NOA-ReACT/electricity-sensors/pcb/images/electrode_production_image1.jpg

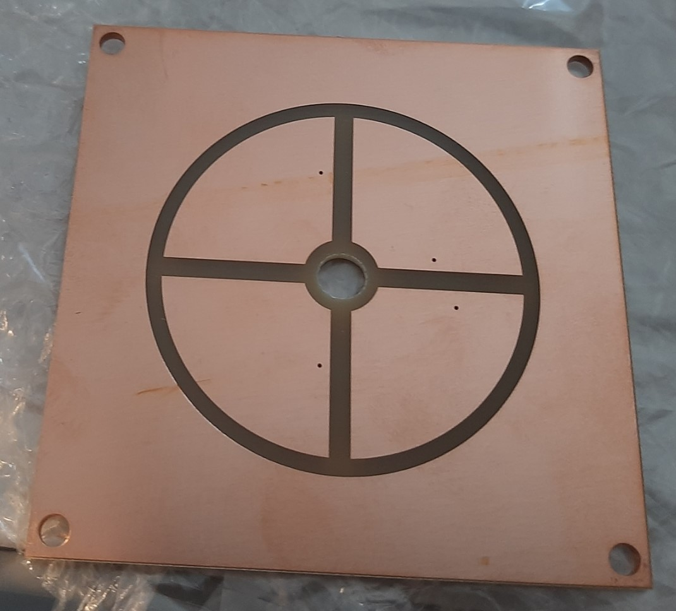
pcb/images/electrode_production_image1.jpg
