NOA-ReACT/electricity-sensors/pcb/images/electrode_production_image2.jpg

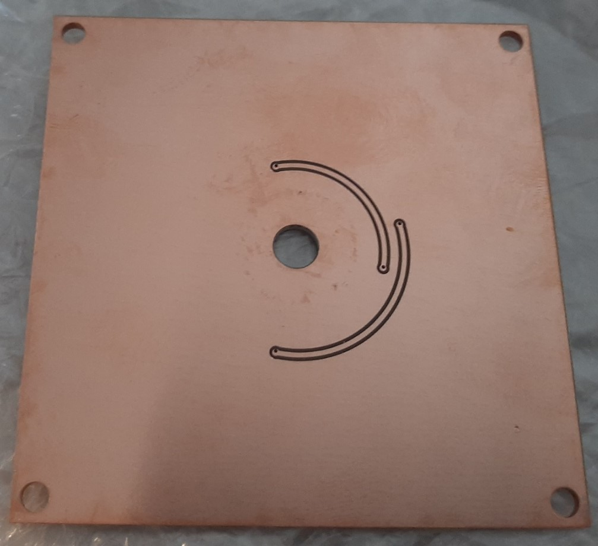
pcb/images/electrode_production_image2.jpg
