NOA-ReACT/electricity-sensors/specs/Charge_sensor_specs.pdf

### NOA - Space Charge Sensor Specs

as in Nicoll & Harrison 2009 , Nicoll 2013

Baud Rate | | Dynamic range
Pre Radiosonde | 115200 | single sensitive channel
On Radiosonde | 9600
| 8 data bits, no parity, one stop bit
| (8N1)
Electrode | | Noise
Brass - spherical | | Zero field error | 1 ADC cnt
Diameter | 15mm | Dark voltage | ~ 4.6mV
Effective Diameter (deff) | 25.4mm
Sampling Rate | | Sensitivity | ± 2.3mV
Pre Radiosonde | 9500 Samples Per Second
On Radiosonde | 1 Sample Per Second | Resolution | ± 2.5V
Modes: | | Accuracy | ~ 10mV
state0 | Regular measurement
state1 | Calibration period 1 | Bandwidth (dB) | through UART
state2 | Calibration period 2 | | Radiosonde defined bandwidth
| | Physical
Spherical Electrode | | Mass | 90 gr (without battery)
Material | Brass | Power | 9V batteries (DC in)
Diameter | 15mm | Consumption | < 100mA
Thickeness | 1.5mm hollow
PCB type: | | Project Box Dimensions:
PCB1 | FR4 1 mm, 35/35μm, double sided
| (PTH), finish: HAL, 34X26mm | Height | 43.8mm
PCB2 | FR4 1 mm, 35/35μm, double sided
| (PTH), finish: HAL, 50X28mm | Length | 101mm
| | Width | 54mm
Microcontroller type
Arduino Nano CH340

Operating environment
Temperature | up to -60o C (with project box)
Altitude | msl to 16km
Humidity | to 100%
