NOA-ReACT/electricity-sensors/pcb/fieldmill_Block_Diagram.jpg

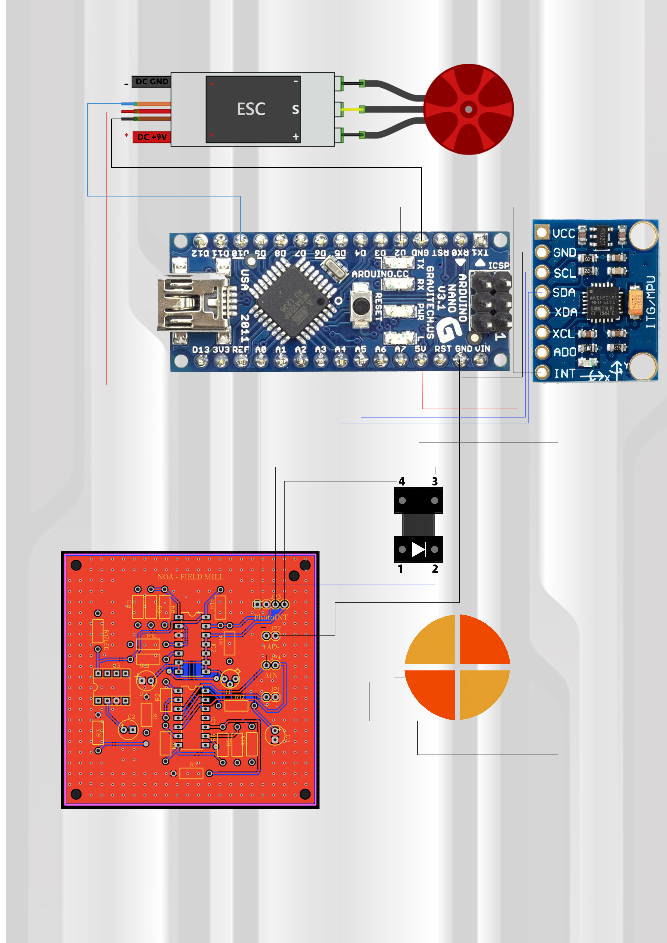
pcb/fieldmill_Block_Diagram.jpg
