NOA-ReACT/electricity-sensors/pcb/images/electrode_PCB_view.png

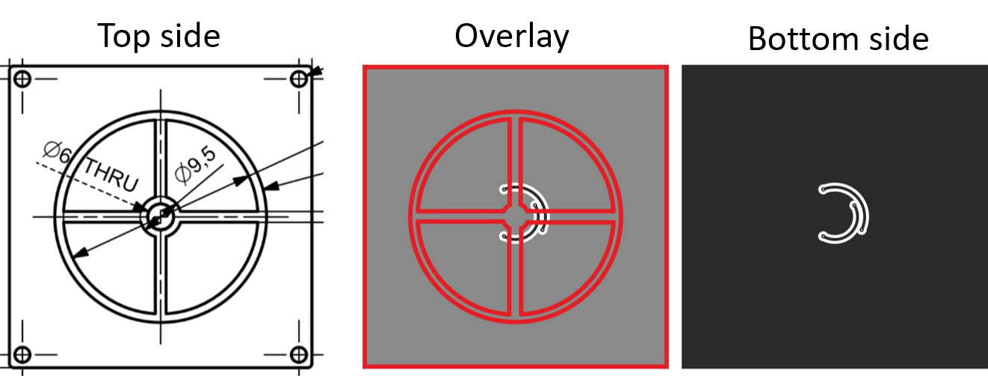
pcb/images/electrode_PCB_view.png
