NOA-ReACT/electricity-sensors/pcb/images/fieldmill_electrode_pcb.pdf

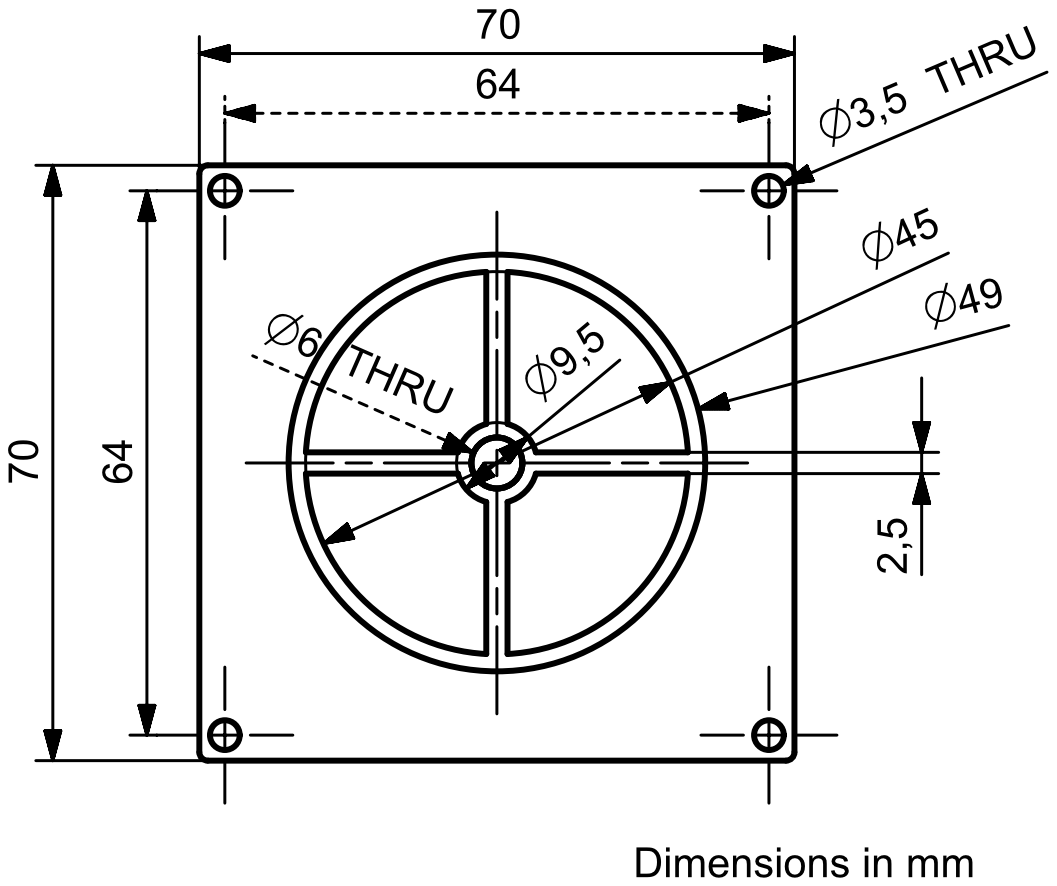
[picture p5: page 1]
