NOA-ReACT/electricity-sensors/pcb/field_mill.sch

## EAGLE design pcb/field_mill.sch (2022-04-07)

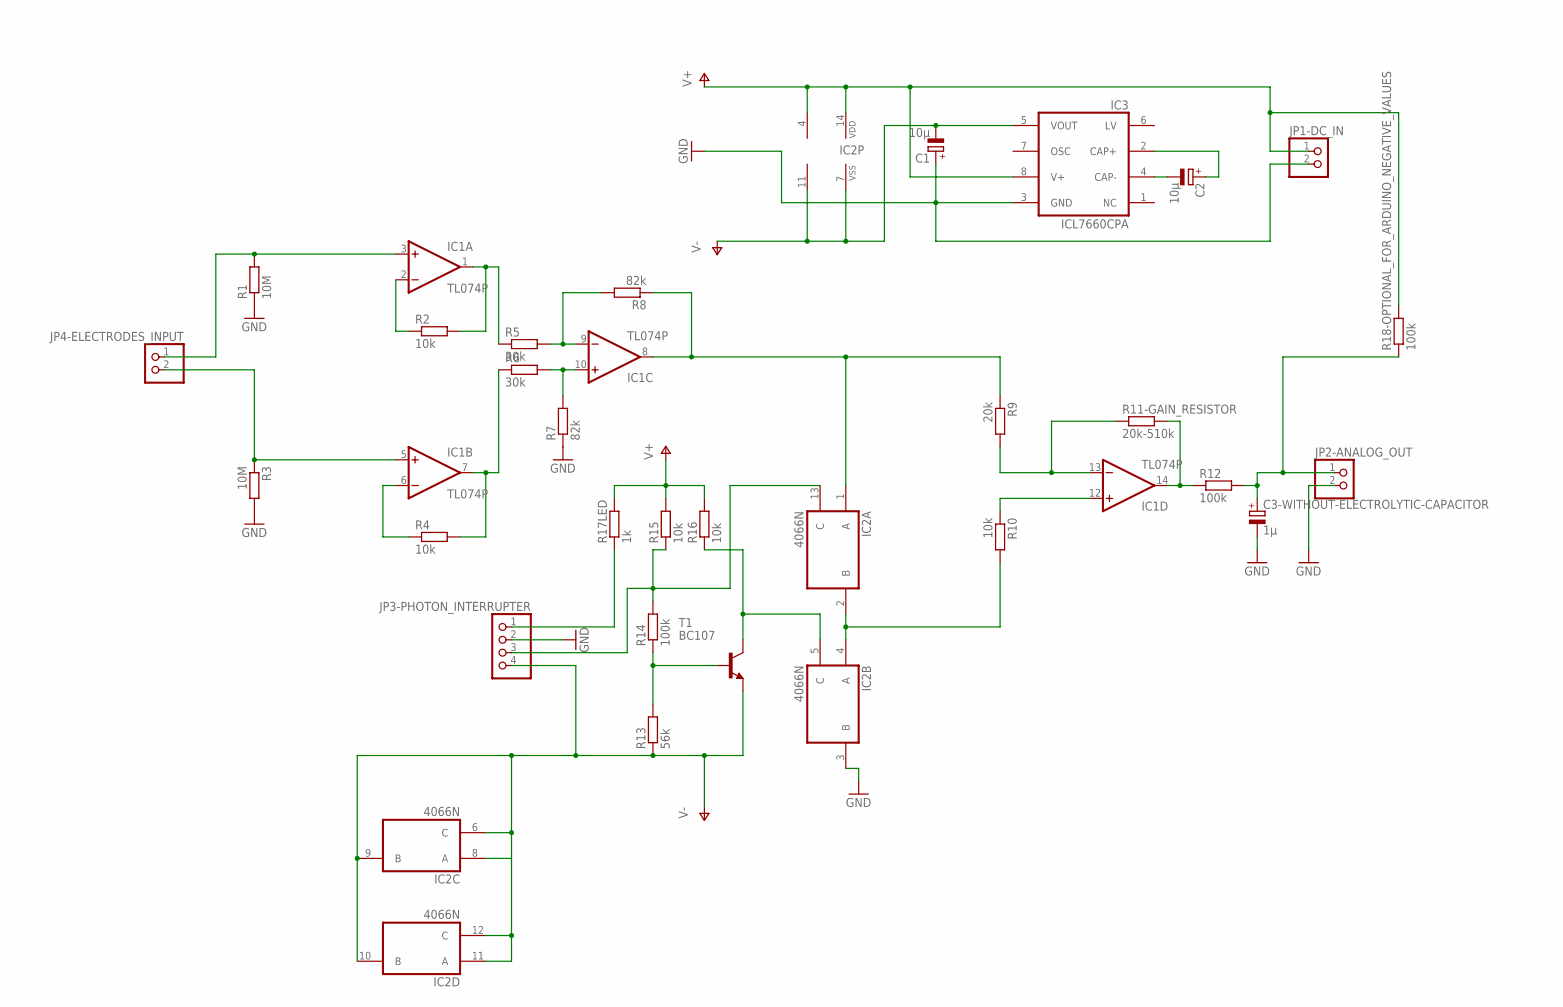
[picture p6: schematic field_mill.sch]

Parts:
C1, C2: 10μ; E2,5-6
C3-WITHOUT-ELECTROLYTIC-CAPACITOR: 1μ; E2,5-6
IC1: TL074P; DIL14
IC2: 4066N; DIL14
IC3: ICL7660CPA; DIL08
JP1-DC_IN, JP2-ANALOG_OUT, JP4-ELECTRODES_INPUT: PINHD-1X2; 1X02
JP3-PHOTON_INTERRUPTER: PINHD-1X4; 1X04
R1, R3: 10M; 0207/10
R2, R4, R10, R15, R16: 10k; 0207/10
R5, R6: 30k; 0207/10
R7, R8: 82k; 0207/10
R9: 20k; 0207/10
R11-GAIN_RESISTOR: 20k-510k; 0207/10
R12, R14, R18-OPTIONAL_FOR_ARDUINO_NEGATIVE_VALUES: 100k; 0207/10
R13: 56k; 0207/10
R17LED: 1k; 0207/10
T1: BC107; TO18

Connections:
GND: C1.+, C3-WITHOUT-ELECTROLYTIC-CAPACITOR.-, IC2.3 (B), IC3.3 (GND), JP1-DC_IN.2, JP2-ANALOG_OUT.2, JP3-PHOTON_INTERRUPTER.2, R1.1, R3.2, R7.1
unnamed: C2.-, IC3.4 (CAP-)
unnamed: C2.+, IC3.2 (CAP+)
unnamed: IC1.9 (-IN), R5.2, R8.2
unnamed: IC1.10 (+IN), R6.2, R7.2
unnamed: IC1.1 (OUT), R2.2, R5.1
unnamed: IC1.8 (OUT), IC2.1 (A), R8.1, R9.1
unnamed: IC1.2 (-IN), R2.1
unnamed: IC1.3 (+IN), JP4-ELECTRODES_INPUT.1, R1.2
unnamed: IC1.6 (-IN), R4.1
unnamed: IC1.7 (OUT), R4.2, R6.1
unnamed: IC1.5 (+IN), JP4-ELECTRODES_INPUT.2, R3.1
unnamed: IC2.2 (B), IC2.4 (A), R10.2
unnamed: IC1.12 (+IN), R10.1
unnamed: IC1.13 (-IN), R9.2, R11-GAIN_RESISTOR.1
unnamed: IC1.14 (OUT), R11-GAIN_RESISTOR.2, R12.1
unnamed: C3-WITHOUT-ELECTROLYTIC-CAPACITOR.+, JP2-ANALOG_OUT.1, R12.2, R18-OPTIONAL_FOR_ARDUINO_NEGATIVE_VALUES.1
unnamed: JP3-PHOTON_INTERRUPTER.1, R17LED.1
unnamed: IC2.13 (C), JP3-PHOTON_INTERRUPTER.3, R14.2, R15.1
unnamed: R13.2, R14.1, T1.2 (B)
unnamed: IC2.5 (C), R16.1, T1.3 (C)
V+: IC1.4 (V+), IC2.14 (VDD), IC3.8 (V+), JP1-DC_IN.1, R15.2, R16.2, R17LED.2, R18-OPTIONAL_FOR_ARDUINO_NEGATIVE_VALUES.2
V-: C1.-, IC1.11 (V-), IC2.6 (C), IC2.7 (VSS), IC2.8 (A), IC2.9 (B), IC2.10 (B), IC2.11 (A), IC2.12 (C), IC3.5 (VOUT), JP3-PHOTON_INTERRUPTER.4, R13.1, T1.1 (E)
