NOA-ReACT/electricity-sensors/pcb/space_charge.sch

## EAGLE design pcb/space_charge.sch (2022-04-07)

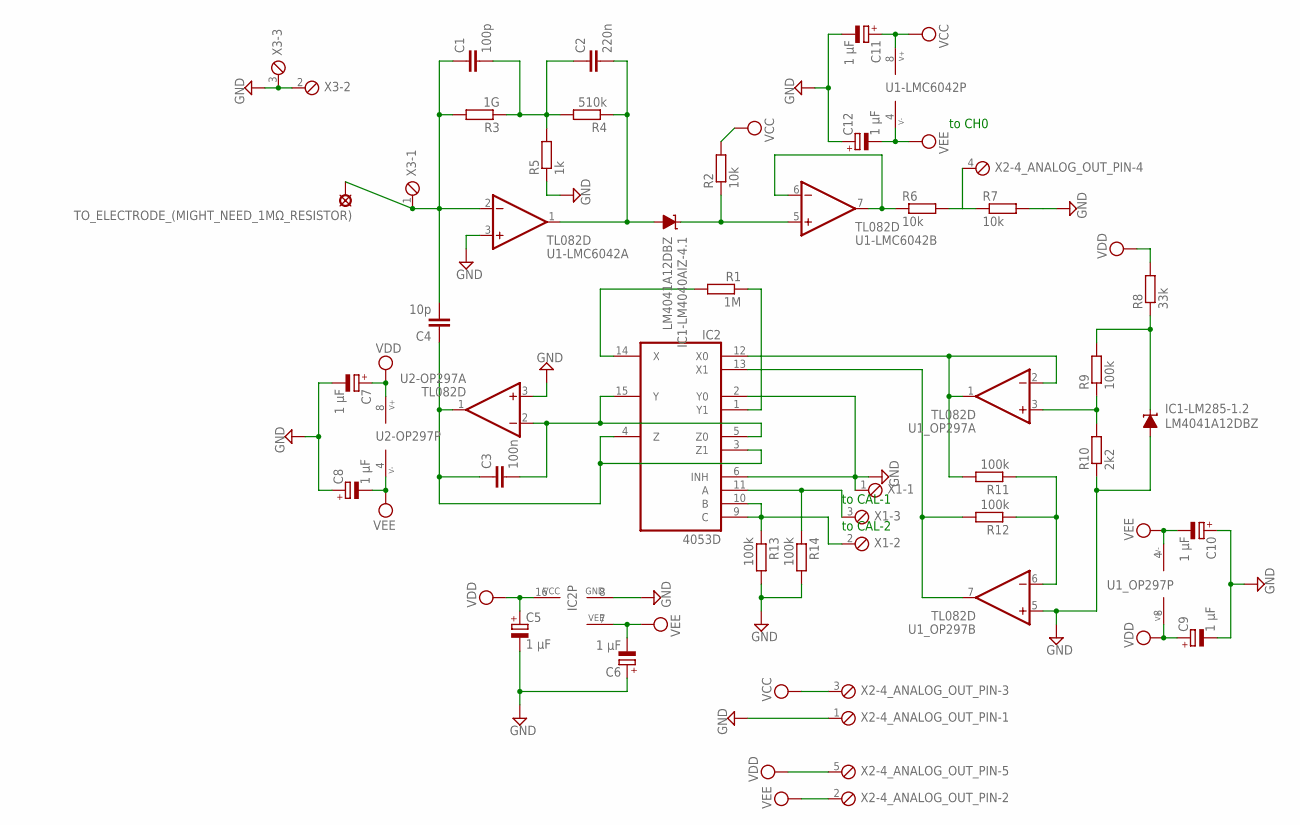
[picture p7: schematic space_charge.sch]

Parts:
C1: 100p; C1206
C2: 220n; C1206
C3: 100n; C1206
C4: 10p; C1206
C5, C6, C7, C8, C9, C10, C11, C12: 1 μF; A/3216-18R
IC1-LM285-1.2, IC1-LM4040AIZ-4.1: LM4041A12DBZ; DBZ_R-PDSO-G3
IC2: 4053D; SO16
R1: 1M; R1206
R2, R6, R7: 10k; R1206
R3: 1G; R1206
R4: 510k; R1206
R5: 1k; R1206
R8: 33k; R1206
R9, R11, R12, R13, R14: 100k; R1206
R10: 2k2; R1206
TO_ELECTRODE_(MIGHT_NEED_1MΩ_RESISTOR): LSP10
U1-LMC6042, U1_OP297, U2-OP297: TL082D; SO08
X1, X3: MPT3; 3POL254
X2-4_ANALOG_OUT_PIN: MPT5; 5POL254

Connections:
CAL-1: IC2.11 (A), R14.1, X1.3
CAL-2: IC2.9 (C), IC2.10 (B), R13.1, X1.2
GND: C5.-, C6.+, C7.-, C8.+, C9.-, C10.+, C11.-, C12.+, IC1-LM285-1.2.2 (A), IC2.2 (Y0), IC2.6 (INH), IC2.8 (GND), R5.1, R7.2, R10.1, R13.2, R14.2, U1-LMC6042.3 (+IN), U1_OP297.5 (+IN), U2-OP297.3 (+IN), X1.1, X2-4_ANALOG_OUT_PIN.1, X3.2, X3.3
unnamed: C1.1, C4.2, R3.2, TO_ELECTRODE_(MIGHT_NEED_1MΩ_RESISTOR).MP, U1-LMC6042.2 (-IN), X3.1
unnamed: C1.2, C2.1, R3.1, R4.2, R5.2
unnamed: C2.2, IC1-LM4040AIZ-4.1.2 (A), R4.1, U1-LMC6042.1 (OUT)
unnamed: IC1-LM4040AIZ-4.1.1 (C), R2.1, U1-LMC6042.5 (+IN)
unnamed: R6.1, U1-LMC6042.6 (-IN), U1-LMC6042.7 (OUT)
unnamed: R6.2, R7.1, X2-4_ANALOG_OUT_PIN.4
unnamed: IC2.14 (X), R1.2
unnamed: IC2.1 (Y1), R1.1
unnamed: C3.2, IC2.5 (Z0), IC2.15 (Y), U2-OP297.2 (-IN)
unnamed: IC2.12 (X0), R11.2, U1_OP297.1 (OUT), U1_OP297.2 (-IN)
unnamed: R11.1, R12.1, U1_OP297.6 (-IN)
unnamed: IC2.13 (X1), R12.2, U1_OP297.7 (OUT)
unnamed: R9.1, R10.2, U1_OP297.3 (+IN)
unnamed: IC1-LM285-1.2.1 (C), R8.1, R9.2
unnamed: C3.1, C4.1, IC2.3 (Z1), IC2.4 (Z), U2-OP297.1 (OUT)
VCC: C11.+, R2.2, U1-LMC6042.8 (V+), X2-4_ANALOG_OUT_PIN.3
VDD: C5.+, C7.+, C9.+, IC2.16 (VCC), R8.2, U1_OP297.8 (V+), U2-OP297.8 (V+), X2-4_ANALOG_OUT_PIN.5
VEE: C6.-, C8.-, C10.-, C12.-, IC2.7 (VEE), U1-LMC6042.4 (V-), U1_OP297.4 (V-), U2-OP297.4 (V-), X2-4_ANALOG_OUT_PIN.2

Notes on the sheet:
to CH0
to CAL-2
to CAL-1
