NOA-ReACT/electricity-sensors/pcb/space_charge_psu.sch

## EAGLE design pcb/space_charge_psu.sch (2022-04-07)

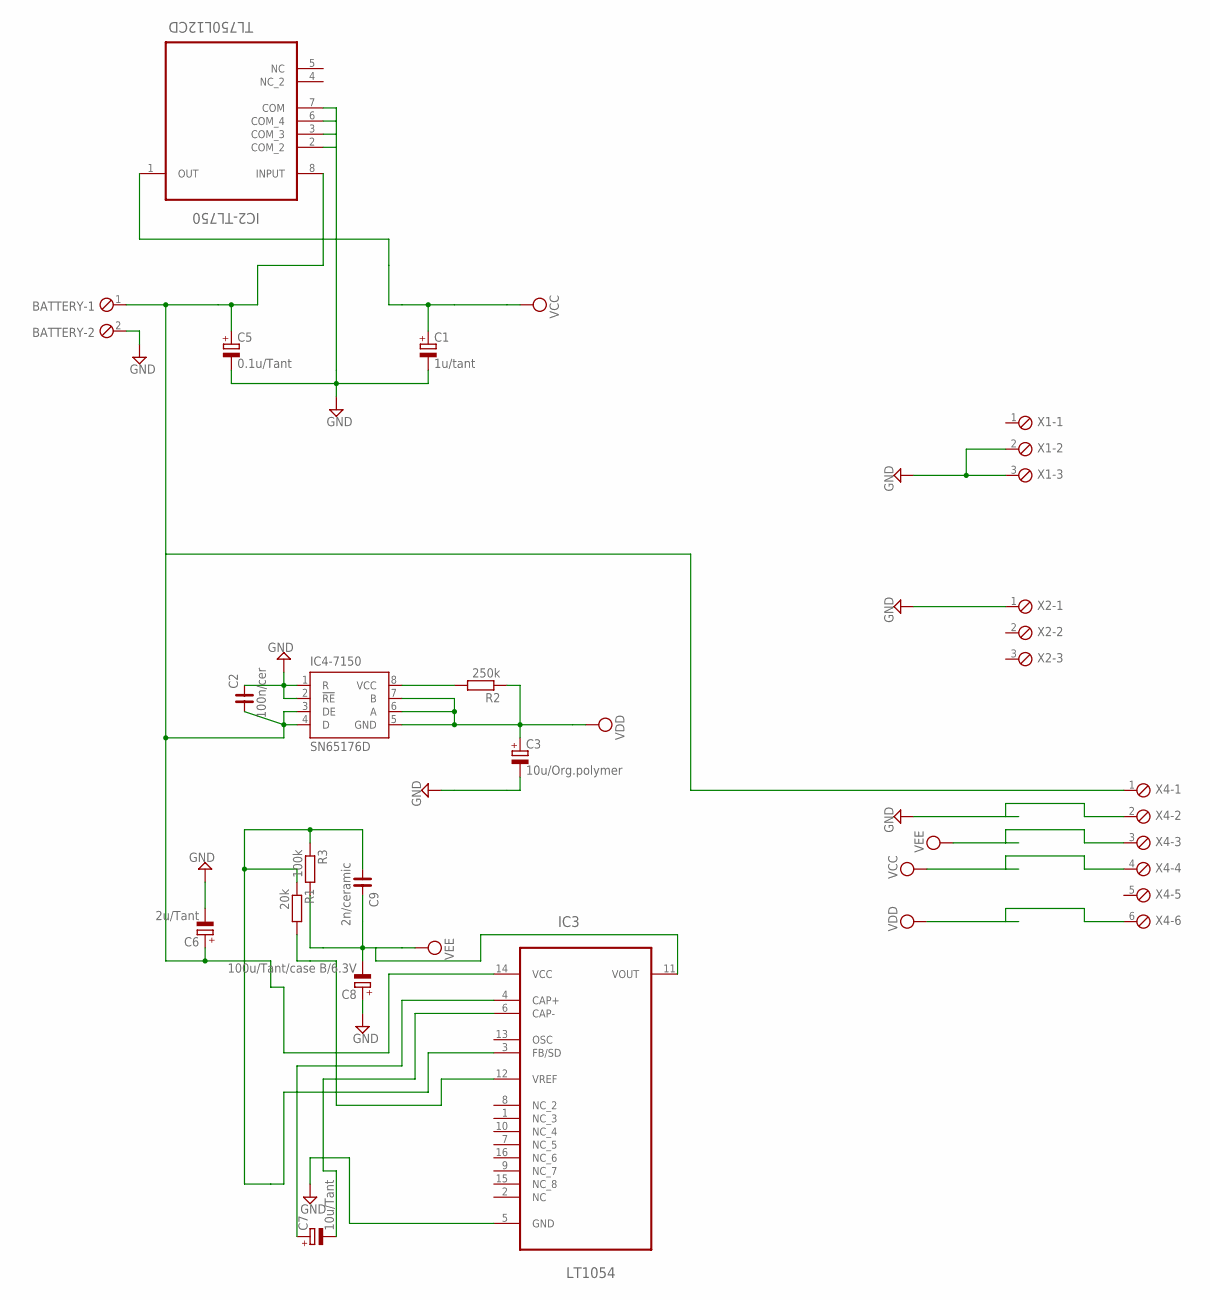
[picture p8: schematic space_charge_psu.sch]

Parts:
BATTERY: MPT2; 2POL254
C1: 1u/tant; A/3216-18R
C2: 100n/cer; C1206
C3: 10u/Org.polymer; 153CLV-0505
C5: 0.1u/Tant; A/3216-18R
C6: 2u/Tant; A/3216-18R
C7: 10u/Tant; A/3216-18R
C8: 100u/Tant/case B/6.3V; B/3528-21R
C9: 2n/ceramic; C1206
IC2-TL750: TL750L12CD; SOIC127P600X175-8N
IC3: LT1054; SOIC127P1030X265-16N
IC4-7150: SN65176D; SO-08
R1: 20k; R1206
R2: 250k; R1206
R3: 100k; R1206
X1, X2: MPT3; 3POL254
X4: MPT6; 6POL254

Connections:
GND: BATTERY.2, C1.-, C2.2, C3.-, C5.-, C6.-, C8.+, IC2-TL750.2 (COM_2), IC2-TL750.3 (COM_3), IC2-TL750.6 (COM_4), IC2-TL750.7 (COM), IC3.5 (GND), IC4-7150.1 (R), IC4-7150.2 (!RE), X1.2, X1.3, X2.1, X4.2
unnamed: BATTERY.1, C2.1, C5.+, C6.+, IC2-TL750.8 (INPUT), IC3.14 (VCC), IC4-7150.3 (DE), IC4-7150.4 (D), X4.1
unnamed: IC4-7150.8 (VCC), R2.2
unnamed: IC3.12 (VREF), R1.2
unnamed: C7.+, IC3.4 (CAP+)
unnamed: C7.-, IC3.6 (CAP-)
unnamed: C9.1, IC3.3 (FB/SD), R1.1, R3.1
VCC: C1.+, IC2-TL750.1 (OUT), X4.4
VDD: C3.+, IC4-7150.5 (GND), IC4-7150.6 (A), IC4-7150.7 (B), R2.1, X4.6
VEE: C8.-, C9.2, IC3.11 (VOUT), R3.2, X4.3
