NOA-ReACT/electricity-sensors/(commit log)

2022-04-07 [pcb] Add designs by V. Spanakis
    [field_mill.sch, space_charge.sch, space_charge_psu.sch]
2022-04-08 [decoder] Fix parsing of floats as doubles (field mill)
2022-04-11 [decoder] New sensor design, "space charge" sensor now transmits data from field mill
    After this change, the library no longer supports multiple sensors, each with different packet schemas, denoted by the second XDATA byte. We now only support packets from the space charge sensor, which may optionally contain data from a field mill sensor.
    This design is less "generic" but we encountered issues with Radiosondes during development when using forwarded packets.
2022-04-11 [firmware] Send field-mill data through space-charge sensor. Do not forward XDATA packets
2022-04-11 [firmware] Move each sketch into a subdirectory for compatibility with Arduino IDE
2022-04-12 [firmware] Fix small formatting issue
    [space-charge.ino]
2022-04-15 [firmware] Field Mill: Take peak-to-peak measurements instead of long averages
2022-04-15 [firmware] Add text mode to Field Mill's serial
    For easier debugging, you can uncomment `SERIAL_TEXT` instead of
    `SERIAL_BINARY` at the top of the file to print data in a friendlier
    format.
2022-04-15 [firmware] Use ElectronicCats/mpu6050 library for MPU in field mill firmware
2022-04-19 [firmware] Fix wrong variables used in Field Mill's text mode :facepalm:
    [field-mill.ino]
2022-06-07 [firmware] In field-mill sketch, take the average value instead of p-p counts
2022-06-07 [firmware] Fix comment reffering to wrong measurement
    [space-charge.ino]
2024-01-22 Create images folder for the pcbs
2024-01-22 Create FIELDMILL_ PCB_topside.jpg
2024-01-22 Revert "Delete pcb/images/FIELDMILL_ PCB_topside.jpg"
    This reverts commit f8f2a29abb34afd4247f13458d13dd06807e14c7.
2024-01-22 Rename electrode_PCB.png
2024-01-22 Add production images from the electrode PCB
