NOA-ReACT/electricity-sensors/(notices)

Notices in the files:
parts and their libraries:
op-amp: Copyright (C) 2006 by Bob Starr
rc-master-smd: Copyright (C) 2007, Bob Starr
